object1037/mizet/README.md

# mizet

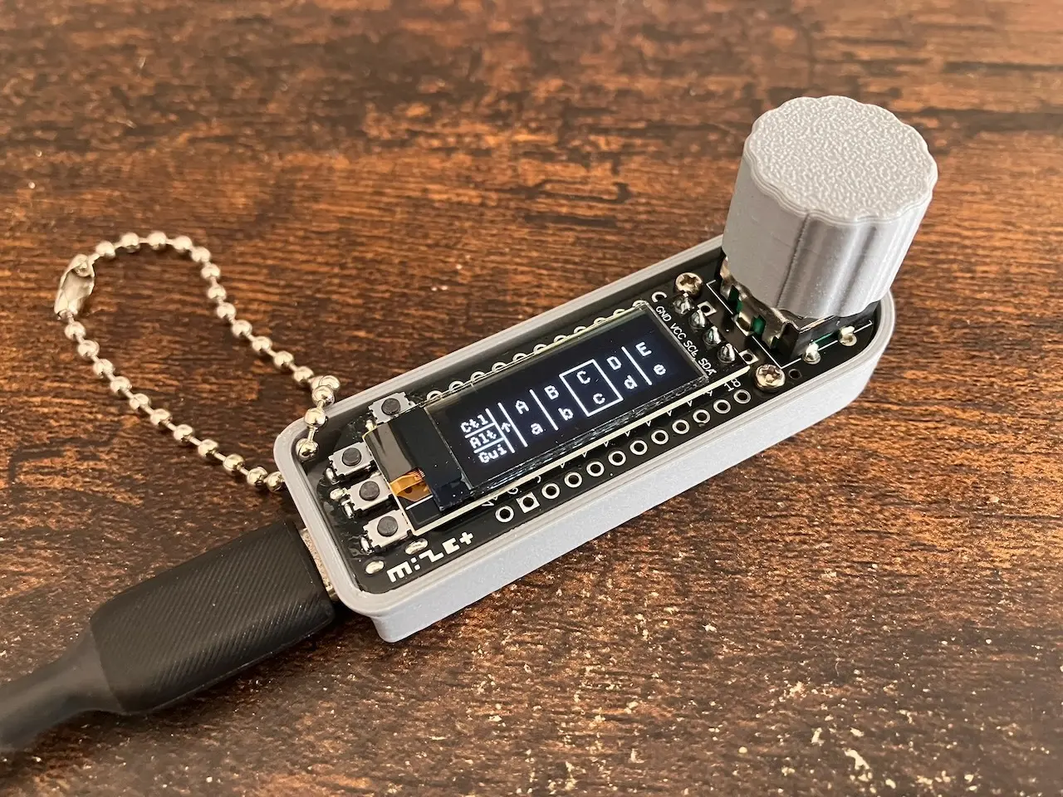
[picture p1: mizet.webp]
mizet


A small input device with keyboard and mouse functionality.
