object1037/mizet/hardware/mizet_case_insert.stl

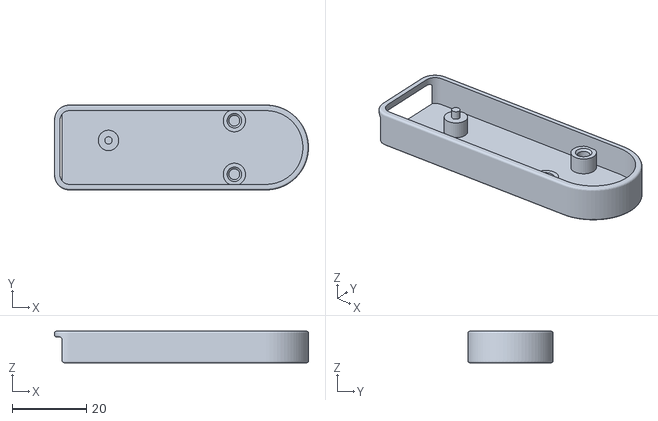
[picture p2: CAD file, 2026-03-30]
hardware/mizet_case_insert.stl
68.2 x 22.8 x 8.50
