object1037/mizet/hardware/mizet_knob.stl

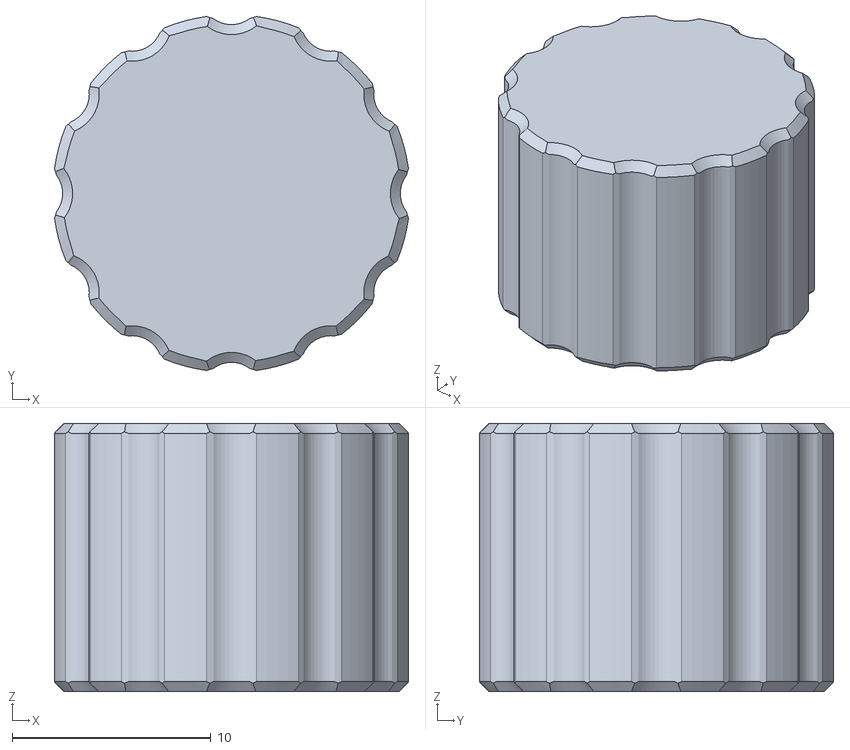
[picture p3: CAD file, 2026-03-30]
hardware/mizet_knob.stl
17.8 x 17.8 x 13.5
