object1037/mizet/hardware/mizet_case.stl

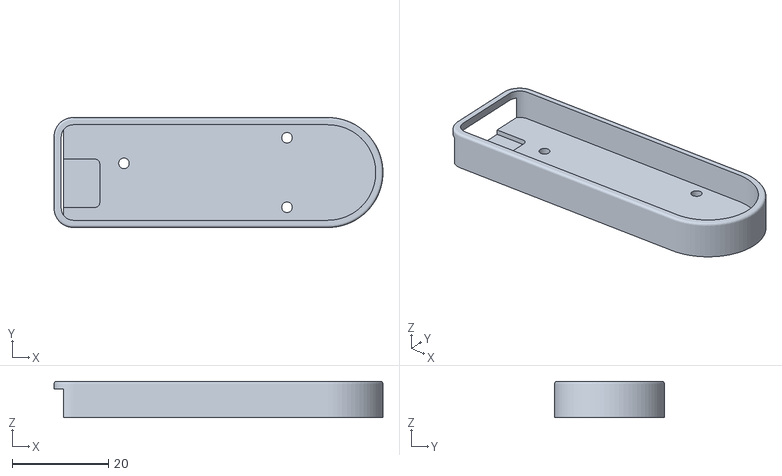
[picture p4: CAD file, 2026-03-12]
hardware/mizet_case.stl
68.2 x 22.8 x 7.50
