object1037/mizet/hardware/bottom_plate.dxf

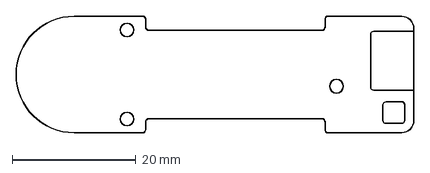
[picture p5: CAD file, 2026-03-08]
hardware/bottom_plate.dxf
64.2 x 18.8 mm
