object1037/mizet/hardware/mizet.step

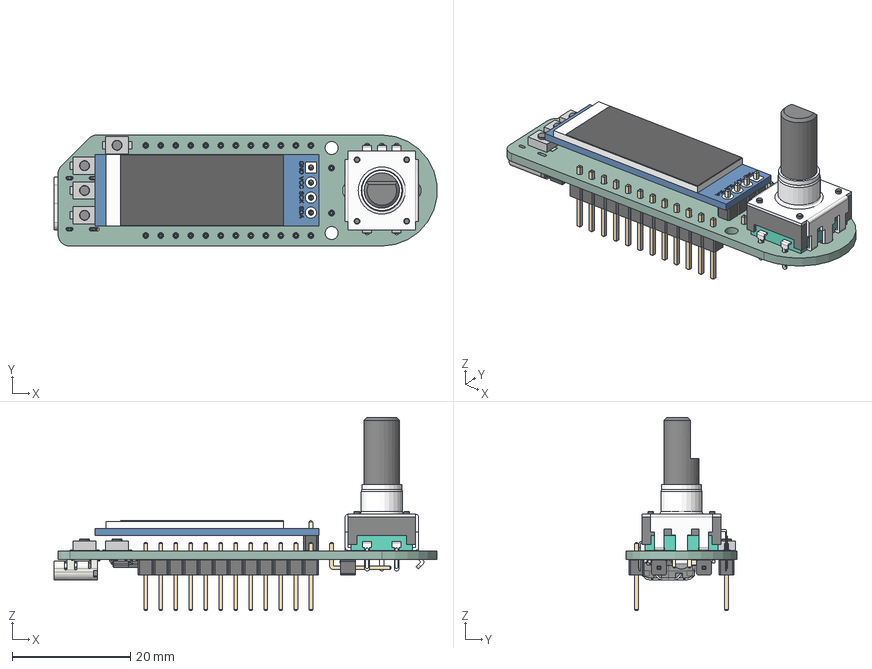
[picture p6: CAD file, 2026-03-08]
hardware/mizet.step
64.8 x 18.8 x 32.7 mm
TS-1088R-02026 x 4
OLED Module v2
Pin Header 2.5 v1
RotarryEncoder_EC12-SW
PinHeader_1x12_P2.54mm_Vertical x 2
R_0603_1608Metric x 2
C_0402_1005Metric x 13
USB_C_Receptacle_GCT_USB4105-xx-A_16P_TopMnt_Horizontal
Crystal_SMD_3225-4Pin_3.2x2.5mm
D_SOD-123
C_0603_1608Metric x 4
QFN-56-1EP_7x7mm_P0.4mm_EP5.6x5.6mm
R_0402_1005Metric x 4
Winbond_USON-8-1EP_3x2mm_P0.5mm_EP0.2x1.6mm
PinHeader_1x01_P2.54mm_Horizontal x 2
SOT-23-3
mizet_PCB
