object1037/mizet/hardware/mizet.kicad_pcb

## KiCad design hardware/mizet.kicad_pcb (2026-03-08)

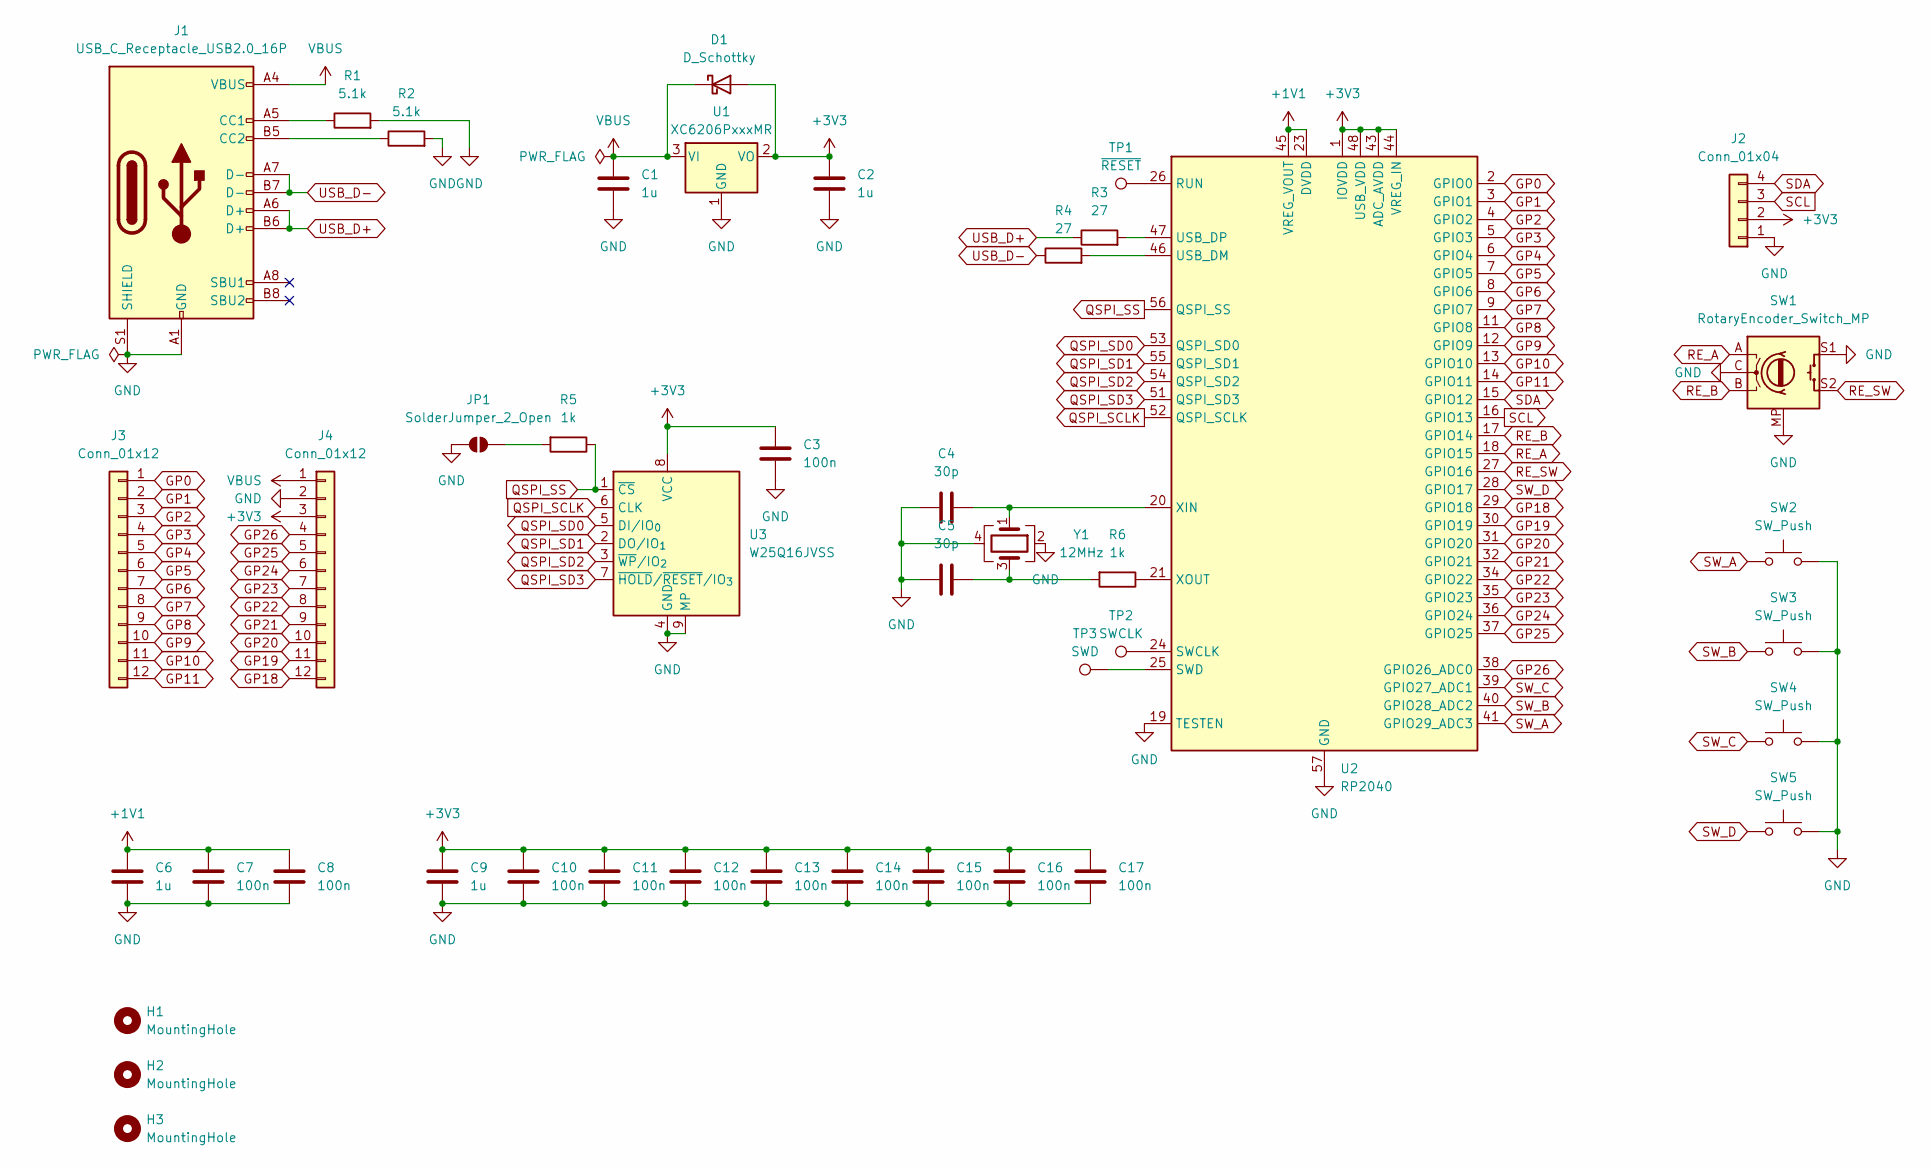
[picture p7: schematic mizet.kicad_sch]

Parts:
C1, C2: 1u; C_0603_1608Metric_Pad1.08x0.95mm_HandSolder
C3, C7, C8, C10, C11, C12, C13, C14, C15, C16, C17: 100n; C_0402_1005Metric_Pad0.74x0.62mm_HandSolder
C4, C5: 30p; C_0603_1608Metric
C6, C9: 1u; C_0402_1005Metric_Pad0.74x0.62mm_HandSolder
D1: D_Schottky; D_SOD-123
H1, H2, H3: MountingHole; MountingHole_2.2mm_M2
J1: USB_C_Receptacle_USB2.0_16P; USB_C_Receptacle_HRO_TYPE-C-31-M-12
J2: Conn_01x04; PinSocket_1x04_P2.54mm_Vertical
J3, J4: Conn_01x12; PinHeader_1x12_P2.54mm_Vertical
JP1: SolderJumper_2_Open; SolderJumper-2_P1.3mm_Open_RoundedPad1.0x1.5mm
R1, R2: 5.1k; R_0402_1005Metric_Pad0.72x0.64mm_HandSolder
R3, R4: 27; R_0402_1005Metric_Pad0.72x0.64mm_HandSolder
R5, R6: 1k; R_0603_1608Metric_Pad0.98x0.95mm_HandSolder
SW1: RotaryEncoder_Switch_MP; RotaryEncoder_Alps_EC12E-Switch_Vertical_H20mm
SW2, SW3, SW4, SW5: SW_Push; tact_sw_smd
TP1: ~{RESET}; TestPoint_Pad_D1.5mm
TP2: SWCLK; PinHeader_1x01_P2.54mm_Horizontal
TP3: SWD; PinHeader_1x01_P2.54mm_Horizontal
U1: XC6206PxxxMR; SOT-23-3
U2: RP2040; RP2040-QFN-56
U3: W25Q16JVSS; Winbond_USON-8-1EP_3x2mm_P0.5mm_EP0.2x1.6mm
Y1: 12MHz; Crystal_SMD_3225-4Pin_3.2x2.5mm

Connections:
+1V1: C6.1, C7.1, C8.1, U2.23 (DVDD), U2.45 (VREG_VOUT), U2.50 (DVDD)
+3V3: C2.1, C3.1, C9.1, C10.1, C11.1, C12.1, C13.1, C14.1, C15.1, C16.1, C17.1, D1.2 (A), J2.2, J4.3, U1.2 (VO), U2.1 (IOVDD), U2.10 (IOVDD), U2.22 (IOVDD), U2.33 (IOVDD), U2.42 (IOVDD), U2.43 (ADC_AVDD), U2.44 (VREG_IN), U2.48 (USB_VDD), U2.49 (IOVDD), U3.8 (VCC)
GND: C1.2, C2.2, C3.2, C4.1, C5.1, C6.2, C7.2, C8.2, C9.2, C10.2, C11.2, C12.2, C13.2, C14.2, C15.2, C16.2, C17.2, J1.A1 (GND), J1.A12 (GND), J1.B1 (GND), J1.B12 (GND), J1.S1 (SHIELD), J2.1, J4.2, JP1.1 (A), R1.2, R2.2, SW1.C, SW1.MP, SW1.S1, SW2.1, SW3.1, SW4.1, SW5.1, U1.1 (GND), U2.19 (TESTEN), U2.57 (GND), U3.4 (GND), U3.9 (MP), Y1.2, Y1.4
GP0: J3.1, U2.2 (GPIO0)
GP1: J3.2, U2.3 (GPIO1)
GP2: J3.3, U2.4 (GPIO2)
GP3: J3.4, U2.5 (GPIO3)
GP4: J3.5, U2.6 (GPIO4)
GP5: J3.6, U2.7 (GPIO5)
GP6: J3.7, U2.8 (GPIO6)
GP7: J3.8, U2.9 (GPIO7)
GP8: J3.9, U2.11 (GPIO8)
GP9: J3.10, U2.12 (GPIO9)
GP10: J3.11, U2.13 (GPIO10)
GP11: J3.12, U2.14 (GPIO11)
GP18: J4.12, U2.29 (GPIO18)
GP19: J4.11, U2.30 (GPIO19)
GP20: J4.10, U2.31 (GPIO20)
GP21: J4.9, U2.32 (GPIO21)
GP22: J4.8, U2.34 (GPIO22)
GP23: J4.7, U2.35 (GPIO23)
GP24: J4.6, U2.36 (GPIO24)
GP25: J4.5, U2.37 (GPIO25)
GP26: J4.4, U2.38 (GPIO26_ADC0)
unnamed: C5.2, R6.2, Y1.3
unnamed: J1.A5 (CC1), R1.1
unnamed: J1.B5 (CC2), R2.1
unnamed: JP1.2 (B), R5.2
unnamed: TP1.1, U2.26 (RUN)
unnamed: TP2.1, U2.24 (SWCLK)
unnamed: TP3.1, U2.25 (SWD)
unnamed: R4.2, U2.46 (USB_DM)
unnamed: R3.2, U2.47 (USB_DP)
unnamed: C4.2, U2.20 (XIN), Y1.1
unnamed: R6.1, U2.21 (XOUT)
QSPI_SCLK: U2.52 (QSPI_SCLK), U3.6 (CLK)
QSPI_SD0: U2.53 (QSPI_SD0), U3.5 (DI/IO_{0})
QSPI_SD1: U2.55 (QSPI_SD1), U3.2 (DO/IO_{1})
QSPI_SD2: U2.54 (QSPI_SD2), U3.3 (~WP/IO_{2})
QSPI_SD3: U2.51 (QSPI_SD3), U3.7 (~HOLD/~RESET/IO_{3})
QSPI_SS: R5.1, U2.56 (QSPI_SS), U3.1 (~CS)
RE_A: SW1.A, U2.18 (GPIO15)
RE_B: SW1.B, U2.17 (GPIO14)
RE_SW: SW1.S2, U2.27 (GPIO16)
SCL: J2.3, U2.16 (GPIO13)
SDA: J2.4, U2.15 (GPIO12)
SW_A: SW2.2, U2.41 (GPIO29_ADC3)
SW_B: SW3.2, U2.40 (GPIO28_ADC2)
SW_C: SW4.2, U2.39 (GPIO27_ADC1)
SW_D: SW5.2, U2.28 (GPIO17)
USB_D+: J1.A6 (D+), J1.B6 (D+), R3.1
USB_D-: J1.A7 (D-), J1.B7 (D-), R4.1
VBUS: C1.1, D1.1 (K), J1.A4 (VBUS), J1.A9 (VBUS), J1.B4 (VBUS), J1.B9 (VBUS), J4.1, U1.3 (VI)

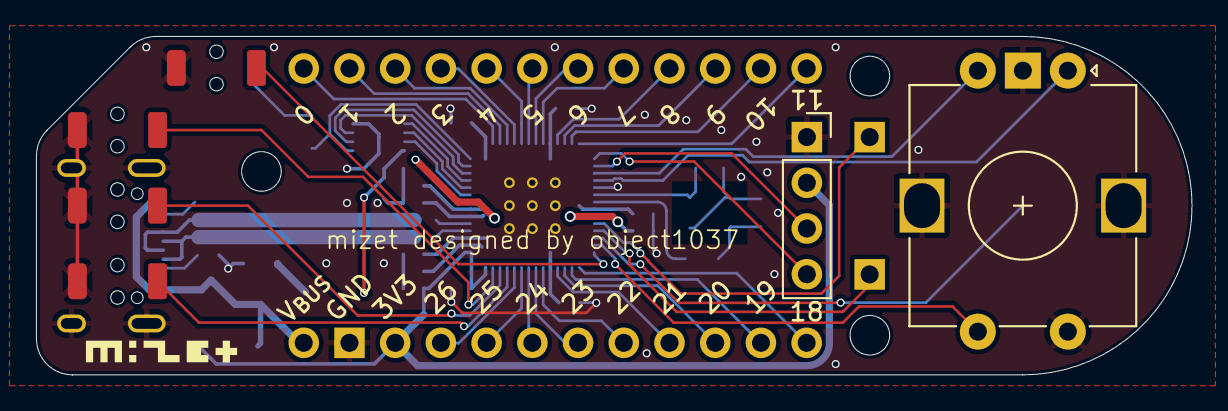
[picture p8: board mizet.kicad_pcb from above]

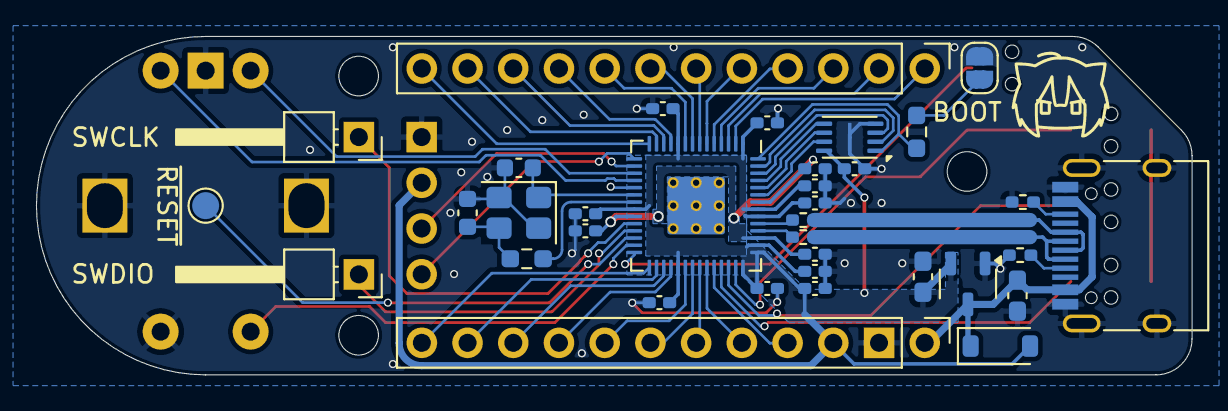
[picture p9: board mizet.kicad_pcb from below]

Board: 2 copper layers, 64.2 x 18.8 mm, 44 parts (35 on the bottom side), 53 nets.
