object1037/mizet/(commit log)

2026-02-23 init with blinky + button
2026-02-23 use rotary encoder
2026-02-25 use async for i2c and ssd1306
2026-02-25 move button handling to separate task
2026-03-04 update i2c pin
2026-03-08 add hardware files
    [BOM-mizet.csv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]
2026-03-08 add case data
    [bottom_plate.dxf, mizet.step]
2026-03-08 update bottom plate
    [bottom_plate.dxf]
2026-03-09 separate encoder and send event
2026-03-09 separate button handling
2026-03-11 tap-hold for button D/Mode
2026-03-11 draw button states
2026-03-12 add case 3d data
    [mizet_case.stl, mizet_case_insert.stl]
2026-03-16 implement move/scroll switch
2026-03-16 separate input handling and button handling
2026-03-30 Update 3dp data
    [mizet_case_insert.stl, mizet_knob.stl]
